2AMLogic/gf180-monosynth/docs/tr808-reference.md

# The Roland TR-808 voice circuits — an engineering reference for a digital 808

**Purpose.** This is the circuit-level reference for implementing an 808 in the
fixed-point drum model and the modal resonator bank of this chip
(`rtl-sketch/modal_dp.v`, `model/modal_fixed.py`). It answers, per voice, *what
generates the tone, at what frequency and Q, with what envelope, through what
filter*, and it ends each voice with a "what to implement" paragraph in DSP
terms. Breadth was traded for accuracy: every number is tagged.

**How claims are tagged.**

- **[verified: KEY]** — read directly in the cited primary source (the service
  notes' schematic or text, or a peer-reviewed analysis of it). Source keys are
  expanded in §0.
- **[inferred]** — computed by me from verified component values with the
  formulas given in §1, or read by me off the schematic scan where the wiring
  is unambiguous. Reproducible; not independently measured.
- **[could not establish]** — no primary source found; do not build on it.

Where a number below disagrees with folklore, the folklore is wrong or refers
to a different unit; see §13 and §15.

---

## 0. Sources actually consulted

| key | source | what it gives | reached |
|---|---|---|---|
| **SN** | Roland, *TR-808 Service Notes*, 1st ed., 15 June 1981 (3rd printing June 1983). Scan: <https://archive.org/details/synthmanual-roland-tr-808-service-notes> (PDF: <https://archive.org/download/synthmanual-roland-tr-808-service-notes/rolandtr-808servicenotes.pdf>) | p.5–6 "Sound Generators" circuit description of every voice; p.9 main-board voice schematic (BD, SD, toms/congas, RS/CL, CP/MA) with component values; p.13 voicing-board schematic (six oscillators, CB, CY, OH, CH); p.14 "typical and variable" tuning chart (frequency, decay time and output amplitude per voice); p.15 design changes | yes, full PDF, read as images |
| **W14a** | K. J. Werner, J. S. Abel, J. O. Smith, "A Physically-Informed, Circuit-Bendable, Digital Model of the Roland TR-808 Bass Drum Circuit", DAFx-14. <https://www.dafx.de/paper-archive/2014/dafx14_kurt_james_werner_a_physically_informed,_ci.pdf> | block-by-block BD analysis with transfer functions, the decay/attack/sigh mechanisms, comparison against SPICE and recordings | yes, full text |
| **W14b** | Werner, Abel, Smith, "The TR-808 Cymbal: a Physically-Informed, Circuit-Bendable, Digital Model", ICMC\|SMC 2014. Zenodo: <https://zenodo.org/record/850891> (DOI 10.5281/zenodo.850890; PDF <https://zenodo.org/api/records/850891/files/smc_2014_220.pdf/content>) | the six Schmitt oscillators and their nominal frequencies, the two band-pass filters, envelope generators, swing VCAs, high-pass filters, tone stage | yes, full text |
| **W14c** | Werner, Abel, Smith, "More Cowbell: a Physically-Informed, Circuit-Bendable, Digital Model of the TR-808 Cowbell", AES 137th Conv., 2014. Abstract: <https://pure.qub.ac.uk/en/publications/more-cowbell-a-physically-informed-circuit-bendable-digital-model>; paper: AES e-lib 17530 (paywalled) | cowbell band-pass analysis | abstract only |
| **W16** | K. J. Werner, *Virtual Analog Modeling of Audio Circuitry Using Wave Digital Filters*, Ph.D. dissertation, Stanford, 2016. <https://stacks.stanford.edu/file/druid:jy057cz8322/KurtJamesWernerDissertation-augmented.pdf> | Table 2.2 (bridged-T R/C values for BD, SD, toms, congas, RS, CL), Table 2.3/4.2 (BD feedback values), Appendix C (tom/conga diode branch) | yes, full text |
| **SOS-BD** | G. Reid, "Practical Bass Drum Synthesis", *Sound On Sound* Synth Secrets. <https://www.soundonsound.com/techniques/practical-bass-drum-synthesis> | qualitative BD description, 808 vs 909 | yes |
| **SOS-SD** | G. Reid, "Practical Snare Drum Synthesis". <https://www.soundonsound.com/techniques/practical-snare-drum-synthesis> | qualitative SD block diagram | yes |
| **SOS-CY** | G. Reid, "Practical Cymbal Synthesis". <https://www.soundonsound.com/techniques/practical-cymbal-synthesis> | six square oscillators, three bands | yes |
| **SOS-CB** | G. Reid, "Synthesizing Cowbells & Claves". <https://www.soundonsound.com/techniques/synthesizing-cowbells-claves> | cowbell/claves description | yes |
| **RW** | R. Whittle, "Modifications for the Roland TR-808". <http://www.firstpr.com.au/rwi/tr-808/> | practitioner statements: per-unit oscillator tuning, noise source, BD self-oscillation mod, snare/clap composition | yes |
| **MI** | Mutable Instruments `eurorack` sources: `peaks/drums/{bass_drum,snare_drum,high_hat}.cc`, `plaits/dsp/drums/{analog_bass_drum,analog_snare_drum,hi_hat}.h`. <https://github.com/pichenettes/eurorack> | a widely-copied open 808 model, for comparison | yes, source read |
| **WP** | Wikipedia, "Roland TR-808". <https://en.wikipedia.org/wiki/Roland_TR-808> | provenance only | yes |
| **MD** | M. Delp, "Anatomy of a Drum Machine". <http://mickeydelp.com/blog/anatomy-of-a-drum-machine> | qualitative only | yes |

Not reached in this pass (state this rather than guess): Eric Archer's 808 pages
(site returns 404/certificate errors), Werner's companion audio pages
(404), the AES cowbell paper body, the Nava/Yocto/x0x clone documentation, and
the Csound/Pd/SuperCollider/VCV implementations. No web search was available
for this pass; everything above was fetched by direct URL.

All frequencies/Q/τ marked [inferred] were computed with the formulas of §1
from the component values in SN and W16. τ is the amplitude 1/e time.

---

## 1. Things common to every voice

### 1.1 Trigger and accent

The CPU (µPD650C) produces a **common trigger** whose ON voltage is set by the
global ACCENT level, **4–14 V**, and per-instrument data that is ANDed with it
to give each voice a **1 ms pulse** of that amplitude **[verified: W14a §3;
SN p.5 Fig. 7 and p.14 "Common Trig with pulse width longer or shorter than
1 ms will be a cause of deteriorative voices"]**. Accent therefore scales the
*excitation* of every voice, not a VCA after it; and because several voices
have nonlinear VCAs downstream, accent changes timbre as well as level
**[verified: W14b §5]**. Roland's chart gives the resulting output swing per
voice at "normal" and "accent" (§1.6): ≈3× for the drums, only ≈2× for
CY/OH/CH, 1.7× for MA **[verified: SN p.14]**.

### 1.2 The bridged-T resonator (the tone generator of BD, SD, toms, congas, RS, CL)

Roland's own text: "The bridged T-network filter shown in Fig. 11 is used to
generate periodic damping drum sound. This configuration has variations
according to application… With this circuit, the decay time becomes longer as
Q increases" **[verified: SN p.5]**. Werner: "The 808 represented Roland's
first implementation of the bridged-T network, and it was used in every single
one of its sound generators in some form… The TR-808 snare drum, lo/mid/hi
tom/congas, and rim shot/clave all use bridged-T networks in similar ways to
the bass drum, to create decaying pseudo-sinusoids in response to impulsive
input. Bridged-T networks are also used as band pass filters in the remaining
voices: handclap, cowbell, cymbal, and open/closed hihat" **[verified: W14a
§5, fn. 15]**.

Topology **[verified: W14a §5–7; W16 Fig. 2.13, 2.27]**: an op-amp with the T
between its inverting input and output — two capacitor "arms" C1 (input side)
and C2 (output side) in series, bridged by R2, with the arms' junction ("foot",
Werner's V_comm) tied to ground through R1. The trigger pulse enters the
non-inverting input. In BD, toms/congas and RS/CL an extra inverting amplifier
feeds the output back into the foot through a resistor R_fb (BD: R170; toms:
R230/R259/R289; CL: R313) — Roland calls this "multi-feedback".

Transfer function from the pulse input (Werner's eq. 5, denominator):

    D(s) = s² R1 R2 C1 C2 + s R1 (C1 + C2) + 1
    f0 = 1 / (2π √(R1 R2 C1 C2))                        (Roland gives this formula, W14a fn. 16)
    Q  = √(R2/R1) · √(C1 C2) / (C1 + C2)   (= ½ √(R2/R1) for C1 = C2)
    τ  = Q / (π f0)                                       (amplitude 1/e)

R1 is the *total* resistance seen from the foot to ground (all shunt paths in
parallel) **[verified: W14a §5, "R_effective = R161 ‖ (R165+R166) ‖ R170"]**.

**With feedback** of (inverting) gain −g into the foot through R_fb, I derived
by nodal analysis the closed-loop denominator (it reproduces Werner's eq. 5
and eq. 7 as special cases) **[inferred]**:

    D_fb(s) = s² R1 R2 C1 C2 + s R1 [ (C1 + C2) − g · R2 C1 / R_fb ] + 1

so **feedback subtracts from the damping term and leaves f0 unchanged to first
order**; Q is multiplied by (C1+C2) / ((C1+C2) − g R2 C1/R_fb), and the network
self-oscillates when g R2 C1 / R_fb ≥ C1 + C2. This is exactly "decay raises
feedback toward self-oscillation". Checked against Roland's chart in §2.

Two real frequency effects exist on top of this, and neither is a "pitch
sweep oscillator": (a) BD only — for the first ≈4–6 ms the foot resistor is
shorted by a transistor, raising f0 by ≈2.6× (§2); (b) toms/congas — a diode
pair in the foot branch conducts at large amplitude, so the pitch starts high
and falls to the small-signal value as the ring decays (§4).

### 1.3 The "swing-type VCA"

Roland's name for a single-transistor common-emitter stage whose collector
supply *is* the envelope voltage, with a diode that shuts it fully off: "The
swing type VCA shown in Fig. 12 is used to generate metallic sound (noise).
This circuit features its output waveform having many high harmonic
components to provide ringing metallic sound" **[verified: SN p.5]**. Werner
analyses it as a modified common-emitter amplifier that clips "wildly" between
the envelope voltage and a lower edge that is itself a function of the
envelope, and fits it with a soft-clip of sharpness α = 3.5 **[verified: W14b
§8]**. It is used by RS (Q62), CB (Q14/Q15), CY (Q16–Q18), OH (Q27) and CH (Q30);
MA's gate (Q65) and the clap's tail VCA (Q70) are similar single-transistor
stages, while the clap's burst VCA is an OTA (IC22, BA662). Its practical
signature is asymmetric clipping whose amount tracks the envelope — i.e. the
hats and cymbal get *more* distorted, not just quieter, as they decay. MI's
Peaks approximates it as "amplifies only the positive section of the signal"
and Plaits as `s *= s > 0 ? 4 : 0.1; s = s/(1+|s|)` **[verified: MI]**.

### 1.4 The noise source

One generator on the main board: a reverse-biased transistor base–emitter
junction in avalanche (Q35, 2SC828-R, with trimmer TM4 setting the white-noise
level to 130 mV rms), buffered by IC24, distributed as a **W.N. (white)** bus
and a **P.N. (pink)** bus **[verified: SN p.8 schematic "NOISE GENERATOR",
p.14 adjustment table "NOISE GENERATOR TM-4 130 mV rms"; RW: "real noise from
a reverse-biased transistor junction going into avalanche breakdown"]**.
Whittle adds that there is "no significant difference in the audible quality
of the noise between one TR-808 and another" **[verified: RW]**. Wikipedia's
story that Kakehashi bought "faulty transistors" for the sizzle is provenance
only **[verified: WP]**.

SD (white, via its own VCA), CP (white, band-passed), MA (white, gated), and
LT/MT/HT (pink, low-passed) consume it. **CY, OH and CH do not use noise at
all** (§1.5).

### 1.5 The six Schmitt-trigger square-wave oscillators (CB, CY, OH, CH)

"The TR-808's Cowbell, Cymbal, Open Hihat, and Closed Hihat voice circuits all
work by filtering and enveloping rectangular waves. In fact, they all share a
common bank of six of these oscillators, ingeniously implemented with a single
HD14584 hex Schmitt trigger inverter chip" **[verified: W14b §3; SN p.6 "The
combined square wave outputs of six Schmitt triggers including two for CB
generator"; SN p.13 schematic, IC1 HD14584]**. Each is a one-resistor
one-capacitor astable; the chip is run from **5 V** (Q9/R60/R61 regulator),
giving amplitude 5 V and duty cycle 47.98 % **[verified: W14b §3]**.

Component values read from the p.13 schematic **[verified: SN]** and the
nominal frequencies Werner derives from them with the HD14584's typical
thresholds **[verified: W14b §3]**:

| osc | R | C | nominal f (W14b) | note |
|---|---|---|---|---|
| 1 (pins 5/6) | R40 560 kΩ | C1 0.018 µF | **205.3 Hz** | fixed |
| 2 (pins 3/4) | R41 560 kΩ | C2 0.01 µF | **369.6 Hz** | fixed |
| 3 (pins 1/2) | R42 680 kΩ | C3 0.01 µF | **304.4 Hz** | fixed |
| 4 (pins 9/8) | R43 220 kΩ | C4 0.018 µF | **522.7 Hz** | fixed |
| 5 (pins 11/10) | TM2 220 kΩ + R45 100 kΩ | C5 0.018 µF | 359.4–1149.9 Hz, **trimmed to 800 Hz** | "COWBELL FREQ.2 1.25 ms" |
| 6 (pins 13/12) | TM1 220 kΩ + R44 150 kΩ | C6 0.022 µF | 254.3–627.2 Hz, **trimmed to 540 Hz** | "COWBELL FREQ.1 1.85 ms" |

Werner's numbers correspond to f = 1/(k·RC) with k = 0.483, i.e. HD14584
thresholds of about V_T+ ≈ 2.7 V, V_T− ≈ 2.1 V at 5 V **[inferred; I
back-computed k from his 205.3 Hz and it reproduces all six of his figures to
0.1 Hz]**. The hysteresis of a 4584/40106 varies substantially between parts
(Roland's own design-change list blames "variations in HD14584 hysteresis" for
the tempo clock drifting out of range **[verified: SN p.15 item 1]**), so the
four untrimmed frequencies are nominal ±(tens of) percent, and "each machine's
six square wave oscillators [have] a unique set of frequencies" **[verified:
RW; W14b fn. 7]**. Only 540 and 800 Hz are factory-trimmed. Early units
(before serial 000300) used R44 = 390 kΩ and R45 = 330 kΩ **[verified: SN
p.15; W14b fn. 9]**.

The six outputs are summed passively through 120 kΩ each (R35, R37, R39, R46,
R48, R50) into R53 = 1 kΩ to ground **[verified: SN p.13; W14b eq. 4]** — a
sum of six 0/5 V squares, heavily attenuated, i.e. a 7-level staircase. This
sum feeds the two cymbal band-pass filters (§10) and, through separate gates,
the cowbell (§9).

### 1.6 Roland's tuning chart (the only manufacturer-published measurements)

Service notes p.14, "CHECKING VOICES … values are typical and variable",
measured at the voice outputs with level at maximum, accent at minimum then
maximum, all other knobs at 12 o'clock. Reproduced verbatim (period in ms,
frequency in Hz) **[verified: SN p.14]**:

| voice | normal Vpp | accent Vpp | f (low knob) | f (mid) | f (high knob) | decay short | decay mid | decay long |
|---|---|---|---|---|---|---|---|---|
| BD | 3.5 | 10 | — | 18 ms (56) | — | 50 ms | 300 ms | 800 ms |
| SD (H / L) | 3 | 10 | — | 2.1 ms (476) / 4.2 ms (238) | — | — | 60 ms | — |
| LC | 3.5 | 12 | 6.1 (165) | 5.4 (185) | 4.5 (220) | — | 180 ms | — |
| LT | 3.5 | 12 | 12.5 (80) | 11.1 (90) | 10 (100) | — | 200 ms | — |
| MC | 3 | 10 | 4 (250) | 3.6 (280) | 3.2 (310) | — | 100 ms | — |
| MT | 3 | 11 | 8.3 (120) | 7.4 (135) | 6.3 (160) | — | 130 ms | — |
| HC | 3.5 | 12 | 2.7 (370) | 2.5 (400) | 2.2 (455) | — | 80 ms | — |
| HT | 3.5 | 12 | 6.1 (165) | 5.4 (185) | 4.5 (220) | — | 100 ms | — |
| C (claves) | 2.5 | 8 | — | 0.4 (2500) | — | — | 25 ms | — |
| RS (H / L) | 3 | 10 | — | 0.6 (1667) / 2.2 (455) | — | — | 10 ms | — |
| M (maracas) | 3 | 5 | — | — | — | 25 ms | — | 35 ms |
| CP | 6 | 2 (sic) | — | — | — | — | 100 ms | — |
| CB (H / L) | 3.5 | 12 | — | 1.25 (800) / 1.85 (540) | — | — | 50 ms | — |
| CY | 3.5 | 7 | — | — | — | 350 ms | 800 ms | 1200 ms |
| OH | 3.5 | 7 | — | — | — | 90 ms | 450 ms | 600 ms |
| CH | 3 | 6 | — | — | — | — | 50 ms | — |

"Decay time" is not defined in the chart. Comparing it with τ computed from
the component values for the voices where the analysis is unambiguous (SD low
60 ms vs τ = 22 ms; LT 200 vs 92; LC 180 vs 91; CP tail 100 vs 47; BD mid 300
vs 144) gives a consistent ratio of **≈2.2–2.7 τ, i.e. the chart's "decay" is
about the time to −20 dB** **[inferred]**. Use τ ≈ chart/2.3 when only the
chart value is available.

### 1.7 Tolerances

"The voice circuits featured ±20 % capacitors and ±5 % resistors. These
variations have significant effects on the gain, center frequency, Q, decay
time, &c. of filter sections, especially when they are in feedback
configurations" **[verified: W14a §11]**. Every f0 below is therefore a ±10 %
nominal, and every high-Q figure a ±50 % nominal. Make all of them
programmable; do not hard-wire.

---

## 2. BD — bass drum

**Topology [verified: W14a §2–9; SN p.5–6; SN p.9 schematic].** Trigger
logic (Q39, Q40) → **pulse shaper** (C40 0.015 µF, R163 100 kΩ, R162 4.7 kΩ,
D53) → **bridged-T resonator** around IC12a (arms C41 = C42 = 0.015 µF,
bridge R167 = 1 MΩ, foot R166 6.8 kΩ + R165 47 kΩ to ground, with Q43 across
R165) with a **feedback buffer** IC12b (R164 47 kΩ in, R169 47 kΩ ‖ (VR6
500 kΩ "DECAY" + C43 33 µF) feedback) returning through R170 470 kΩ into the
foot; an **envelope generator** (Q41, Q42, C38 0.1 µF, R156 1 MΩ) that drives
Q43 and also produces a **retrigger pulse** through C39 0.033 µF / R161 1 MΩ /
D52 into the foot; then **tone** (R171 220 Ω + R172 10 kΩ ‖ VR5 10 kΩ, into
C45 0.1 µF — a passive 1-pole low-pass), **level** VR4, and an output buffer
Q44 with a DC-blocking high-pass (C49 0.47 µF, R176 100 kΩ, R177 82 kΩ).
Component values: W16 Tables 2.3 and 4.2 and the p.9 schematic agree.

**Pulse shaper [verified: W14a §4].** A passive low-shelf plus a diode. The
rising edge delivers the full trigger amplitude V_TRIG (4–14 V); the falling
edge, 1 ms later, is ≈ V_TRIG·R162/(R162+R163) + 0.71 V ≈ 0.045·V_TRIG + 0.7 V
and is clamped by D53 so the output never goes below ≈ −0.7 V. "It is the
edges of the shaped pulse that will kick the bridged-T network into
oscillation."

**Resonator [verified: W14a §5; computed with §1.2, inferred].**
R1 = R161 ‖ (R165+R166) ‖ R170 = 46.1 kΩ, R2 = 1 MΩ, C = 0.015 µF:
**f0 = 49.4 Hz, open-loop Q = 2.33 (τ = 15 ms)**. Werner reports "≈49.5 Hz,
which is close to the entry in Roland's 'typical and variable' tuning chart
(56 Hz)"; the service-notes text speaks of "16 ms … inherent oscillation
period" (62.5 Hz); Werner's SPICE/model plots of instantaneous frequency sit
between 48 and 58 Hz over the first 300 ms **[verified: W14a Fig. 11]**. Treat
**50–56 Hz** as the target and make it tunable.

**Decay control [verified: W14a §6; law inferred, §1.2].** The feedback
buffer's audio-band gain is g = (R169 ‖ k·VR6)/R164 for knob position k
(0 at k = 0; 0.914 at k = 1; C43 only blocks DC). Closed-loop Q from the §1.2
law with R_fb = R170:

| VR6 position k | g | Q | τ | 2.3 τ | Roland chart |
|---|---|---|---|---|---|
| 0 | 0 | 2.3 | 15 ms | 34 ms | — |
| 0.1 | 0.515 | 5.2 | 33 ms | 76 ms | "short" 50 ms |
| 0.5 | 0.842 | 22.3 | 144 ms | 330 ms | "mid" 300 ms |
| 0.9 | 0.905 | 63 | 408 ms | 0.94 s | "long" 800 ms |
| 1.0 | 0.914 | 84 | 544 ms | 1.25 s | |

Self-oscillation needs g = 0.94; the stock circuit tops out at 0.914, so the
stock BD **cannot quite sustain**, which is why Whittle's modification
"extends the Bass Drum decay range to include self-oscillation, so any decay
time from the normal minimum to infinity can be achieved" **[verified: RW]**.
The frequency is unchanged by the decay knob to first order. **Hypothesis 1
for the BD is confirmed.**

**Attack frequency shift [verified: W14a §8.1; SN p.6].** For the duration of
the envelope generator's pulse the collector of Q43 shorts R165, so the foot
resistance drops from 53.8 kΩ to 6.8 kΩ (R1 → 6.66 kΩ) and **f0 rises to
≈130 Hz with Q ≈ 6** for ≈4 ms (SN: "the ON period of Q43 is determined by
R156 and C38 and equals 4 ms which is ½ × ½ of 16 ms") — Werner measures ≈6 ms.
"Although this brief change of center frequency (≈6 ms, less than a single
period at the higher frequency) isn't long enough to be perceived as a pitch
shift, it greatly affects the sound of the bass drum's attack, making it
'punchier' and 'crisper'." When Q43 releases, C39/R161/D52 apply a
**retriggering pulse** so the amplitude does not collapse when the resonance
jumps back down **[verified: W14a §8.1; SN p.6]**.

**Pitch "sigh" [verified: W14a §8.2].** Separate from the attack shift: when
the foot node swings below ≈ −0.7 V, Q43's base–emitter conducts, drawing
current that lowers R_effective and raises f0 slightly; as the ring decays the
frequency relaxes back — a downward glide of a few percent over the first few
hundred ms ("goes slightly flat at long decays" **[verified: SOS-BD]**).
Werner fits it as a memoryless nonlinearity i_C = f(V_comm) (his eq. 8,
α = 14.315, V0 = 0.556, m = 1.4765·10⁻⁵).

**Tone [verified: W14a §9; values SN p.9; corner inferred].** One-pole RC
low-pass, R_eq = R171 + (R172 ‖ VR5·l), C45 = 0.1 µF: **corner from ≈7.2 kHz
(VR5 = 0, all click) down to ≈305 Hz (VR5 max)**. It acts on resonator *and*
click alike; the click *is* the shaped pulse leaking straight through (Plaits
models this as `exciter_leak = 0.08·(tone+0.25)` **[verified: MI]**).

**Retrigger while ringing [verified: W14a §11].** Because the resonator is a
filter with state, "each note is slightly different, as in a real 808, since
the remaining filter states may interfere constructively or destructively with
the response to a new trigger".

**What to implement (BD).** *Amended 2026-09-18 (DR 0009,
`drum-verification.md` §8.3): **f0 = 49.4 Hz**, not 56. The 56 Hz below was
Roland's chart's, and it contradicts this section's own derivation from the
component values four paragraphs above. It is also incompatible with the decay
table above: that table's Q and τ columns satisfy τ = Q/(π f0) to 1.5 % at
49.4 Hz and only to 12.8 % at 56, so the table is computed at 49.4. Two sample
sets measure 48.8–51.6 Hz.*

One two-pole resonator (a modal-bank mode) at
~~f0 = 56 Hz~~ **f0 = 49.4 Hz** (tunable 45–65 Hz), excited by a **1 ms rectangular pulse** of
amplitude ∝ accent. (The analog pulse shaper turns that pulse into a
positive kick of A at t = 0 and a negative kick of ≈0.05A + 0.7 V at t = 1 ms,
clamped at −0.7 V: a 1-pole high-pass with τ ≈ 0.1 ms and a one-sided clamp
reproduces it; feeding the raw 1 ms pulse into the bank is close enough to
start with.) Set the pole radius set from the decay knob by the table above
(Q = 2.3 → 84, τ = 15 → 540 ms; r = exp(−π f0/(Q f_s))). Optional but cheap
and audible: for the first 4 ms load the "attack" coefficients (f0 ≈ 130 Hz,
Q ≈ 6) and then switch to the normal ones while adding a second, smaller
negative kick (the retrigger). Optional: a pitch glide of −2…−5 % over 300 ms
that scales with amplitude (the sigh). Follow with a 1-pole low-pass whose
corner is the tone knob (305 Hz … 7.2 kHz) applied to resonator + a copy of the
excitation pulse (the click). Do **not** reset the resonator state on a new
trigger. The output high-pass is at 3.4 Hz — ignore it. Q2.24 coefficients at
48 kHz: see §14.

---

## 3. SD — snare drum

**Topology [verified: SN p.6 "This sound generator has two bridged
T-networks for fundamental waveforms and harmonic waveforms. The output ratio
of the two can be changed by VR8 (TONE) to tailor sound characteristic. The
amplitude of snappy envelope can be controlled by VR9 (SNAPPY)"; SN p.9
schematic; W16 Table 2.2; RW: "composed of the Snappy noise pulse and the
ringing of two 'Bridged T-Network' resonators, with the Tone pot controlling
the mix of the outputs of the two resonators"].**

Two bridged-T resonators around the two halves of IC14, with no feedback
buffer (the SD is not "multi-feedback"):

| | R1 (foot) | R2 (bridge) | C1, C2 | f0 [inferred] | Q [inferred] | τ | Roland chart |
|---|---|---|---|---|---|---|---|
| low, IC14a | R196 680 Ω | R197 820 kΩ | C58 = C59 = 0.027 µF | **250 Hz** | 17.4 | 22 ms | **238 Hz**, 60 ms |
| high, IC14b | R195 2.2 kΩ | R198 1 MΩ | C60 = C61 = 0.0068 µF | **499 Hz** | 10.7 | 6.8 ms | **476 Hz** |

So the June-1981 machine's snare is **≈240 Hz + ≈480 Hz, a 1 : 2 ratio**, with
the upper partial decaying 3× faster **[verified: SN chart; values SN/W16;
Q, τ inferred]**. The hypothesis "≈180 Hz and ≈330 Hz" is **refuted for the
1981 unit — but see the design change below, which lands exactly there.**

**Design change ("PORTION CHANGED" box on the p.9 schematic, 1983 printing)
[verified: SN p.9]:** "SD: C58 .027 to .056; C61 .0068 to .015; R191 8.2k to
10k; R200 47k to zero." No serial number or reason is given (the p.15
design-change table does not list it). With those values **[inferred]**:
low f0 = 1/(2π√(680·820k·0.056µ·0.027µ)) = **173 Hz** (Q 16, τ 30 ms);
high f0 = **336 Hz** (Q 10, τ 9.4 ms) — ratio 1.94. Later 808s therefore have
a snare a fourth lower than early ones. The tuning chart on p.14 was not
updated. Build both presets; default to the later one (it is the sound most
recordings and samples come from, but that is [inferred] from the chronology,
not measured).

**Excitation and the cascade [inferred from the schematic, SN p.9].** The
trigger (Q45/Q46) is shaped by R189 100 kΩ ‖ C57 0.0068 µF into R190 680 Ω and
enters IC14a's non-inverting input. IC14a's *output* is divided by R191
8.2 kΩ / R192 220 Ω (≈1/38) into IC14b's non-inverting input — the **high
resonator is driven by the low resonator's output, not by the pulse
directly**, so it is excited continuously by the fundamental and the two
partials are phase-locked. (Peaks and Plaits excite both with the pulse; the
difference is subtle.) IC13 sums IC14a (via C63 0.047 µF) and IC14b (via R200
47 kΩ → 0 Ω after the change, C65 0.047 µF) through VR8 TONE 100 kΩ(B), plus
the noise.

**Snappy / noise path [verified: SN p.6 text; wiring inferred from p.9].**
VR9 SNAPPY 10 kΩ(B) sets the amplitude of the trigger pulse fed to Q47, which
charges C51 0.47 µF through R186 33 kΩ (τ ≈ 15.5 ms) — the *noise envelope*.
That envelope controls Q48, a transistor VCA on the white-noise bus (W.N.
via C56 0.022 µF, R188 100 Ω). Q48's output goes through a Sallen-Key
high-pass on emitter follower Q49 (C66 = C67 = 0.0018 µF, R201 22 kΩ feedback,
R202 47 kΩ): **f0 ≈ 2.75 kHz, Q ≈ 0.7** **[inferred]**, then C69 0.01 µF /
R205 27 kΩ into the IC13 mixer. **"Snappy" is the noise level (via its
envelope amplitude); it does not change the resonators** — contrary to
SOS-SD's description, in which "the snappy signal is attenuated and added to
the trigger itself and directed to both oscillators"; the schematic shows VR9
only in the Q47 noise-envelope path **[inferred from SN p.9]**. The noise
envelope's decay is fixed (≈15 ms RC, so the "snap" is a 30–40 ms burst);
the tone resonators' decays are fixed by their component values.

**What to implement (SD).** Two modal-bank modes: low at 173 Hz (Q 16) and
high at 336 Hz (Q 10) [later units], or 238/476 Hz (Q 17/11) [early units].
Excite the low mode with the 1 ms pulse; excite the high mode from the low
mode's output ×1/38 (or, if the bank cannot chain, from the same pulse — the
loss is small). TONE = crossfade of the two mode amplitudes (Roland: "output
ratio of the two"). Noise: white LFSR × exponential envelope → 2-pole filter
at 2.75 kHz Q 0.7 → add. Total: 2 resonator modes + 1 noise biquad + 1
envelope.

> **AMENDED 2026-09-18 from hardware** (`docs/drum-verification.md` §8.1,
> §8.6; contract 17.22, 17.24, 17.25). Three numbers in this section are
> right and three readings of them are not:
>
> - the noise filter is a **band-pass** on the stated pole, not a high-pass.
>   The pole (2.75 kHz, Q 0.7) is kept exactly; only the numerator changes. A
>   high-pass on that pole is flat to Nyquist, and the machine's snare noise
>   peaks at 3–5 kHz and falls above (band-pass 1.9 dB weighted rms against
>   the high-pass's 5.2);
> - the noise envelope's decay is **τ ≈ 30 ms**, not the 15.5 ms of
>   R186 × C51 — which is the *charge* path. The machine's burst measures T20
>   63–78 ms over six files, and this section's own prose ("the snap is a
>   30–40 ms burst") agrees with the measurement rather than with the RC;
> - TONE's crossfade has a **measured value at 12 o'clock**: the upper partial
>   sits at **1.42×** the lower, the same with the snappy path up and down.
>   What is *not* solved is that ratio from R191/R192/VR8/R200; it is measured,
>   not derived.

---

## 4. LT / MT / HT and LC / MC / HC — toms and congas (three shared circuits)

**Topology [verified: SN p.6: "These three sound generators are composed of
the circuits based on the same principle… composed of a multi-feedback,
bridged T-network including IC5 as an active element. Voices are switched by
SW8 (C77 — frequency, R224 — level). While the oscillation is large in
amplitude immediately after triggering, it is on a higher frequency due to
conductions of D80 and D81, which reduce time constant of the filter. As the
resonance is damped, its frequency is lowered by the effect of increasing
diodes' internal resistance… Pink noise with a slightly longer decay time is
mixed for Low Tom Tom to provide artificial reverberation"; SN p.9 schematic;
W16 Table 2.2, Appendix C].** The tom and the conga of each pair are **the same
resonator with a capacitor switched in (tom) or out (conga)** and, for toms
only, a pink-noise path switched in. The panel switch selects one or the other;
they cannot sound together.

Values (SN p.9 / W16 Table 2.2) **[verified]**; frequencies **[inferred]** with
R1 = (1−x)·VR + R_side = 1.0–1.5 kΩ (VR11/13/15 = 500 Ω TUNING, R231/260/287 =
1 kΩ, diodes 1S188FM germanium *non-conducting* at small signal), R2 = 820 kΩ
(R228/R257/R284), feedback g = 1 through 820 kΩ (R230/R259/R289; IC15b/17b/18b
are unity-gain inverters, 33 kΩ/33 kΩ):

| voice | C1 (input arm) | C2 (output arm) | f0 at tuning min/mid/max | Roland chart | Q (with fb) | τ | chart decay |
|---|---|---|---|---|---|---|---|
| LT | C76 0.056 µF | C78 0.012 + C77 0.047 = 0.059 µF | 79 / 86 / 97 Hz | 80 / 90 / 100 | 25 | 92 ms | 200 ms |
| LC | C76 0.056 | C78 0.012 | 175 / 192 / 214 | 165 / 185 / 220 | 55 | 92 ms | 180 ms |
| MT | C89+C90 0.0352 | C91+C92 0.039 | 123 / 134 / 150 | 120 / 135 / 160 | 24 | 58 ms | 130 ms |
| MC | C90 0.027 | C92 0.012 | 252 / 276 / 309 | 250 / 280 / 310 | 38 | 44 ms | 100 ms |
| HT | C103 0.027 | C104+C105 0.0276 | 166 / 182 / 204 | 165 / 185 / 220 | 25 | 44 ms | 100 ms |
| HC | C103 0.027 | C105 0.0056 | 369 / 404 / 452 | 370 / 400 / 455 | 56 | 44 ms | 80 ms |

The agreement with Roland's chart is within 5 % across all six once the diodes
are treated as open **[inferred]**. (W16 Table 2.2 lists R1 = 333–500 Ω, which
is the diode-*conducting* limit; with those values every frequency comes out
1.7× too high against the chart — that is the large-signal pitch, see next.)

**Pitch drop [verified: SN text; magnitude inferred].** With the diodes fully
conducting the foot resistance becomes (1−x)·500 + 1 kΩ ‖ x·500 → 333–500 Ω,
i.e. f0 up to ≈1.7× the small-signal value (LT ≈ 145 Hz at the very start of
a hard hit, settling to 86 Hz). The transition is amplitude-dependent and
gradual (germanium diode, soft knee), not a stepped envelope. The congas share
the mechanism. This, not any envelope, is the toms' characteristic "doom"
sweep; it also means **accent changes the pitch envelope**.

**Noise (toms only) [verified: SN text; values inferred from p.9].** The
P.N. bus is gated by Q52/Q55/Q58 with an envelope from a diode-charged RC
(D55, C72 0.039 µF, R218 2.2 MΩ / R216 15 kΩ — ≈85 ms decay), low-passed by
R222 22 kΩ / C75 0.018 µF (**≈400 Hz, 1-pole**) and mixed in only in the tom
position of the switch. SN mentions it for LT ("slightly longer decay time
… artificial reverberation"); the schematic has the same path on all three.
It is a quiet, dark rumble under the tone.

**What to implement (toms/congas).** One modal-bank mode per voice at the
chart frequency (LT 90, MT 135, HT 185 / LC 185, MC 280, HC 400 Hz; the TUNING
pot spans ±10 %), Q ≈ 25 (toms) / ≈ 40–55 (congas), excited by the 1 ms pulse
× accent. Add the **amplitude-dependent pitch offset**: f = f0·(1 + 0.7·
sat(|y|/y_knee)) or, cheaper, a decaying pitch offset of +40 % → 0 over
≈ 2τ scaled by accent — the bank must accept per-sample coefficient updates or
a short coefficient ramp (a 4–8 step ramp of a1 is enough; a2 changes little).
Toms only: pink noise (LFSR + 1-pole low-pass at ≈400 Hz) × envelope
(τ ≈ 85 ms) at low level. Congas: no noise.

---

## 5. RS — rimshot, and 6. CL — claves (one shared circuit, switch SW11)

**Topology [verified: SN p.6 "RS/CL"; SN p.9 schematic; W16 Table 2.2].**
Two bridged-T networks:

- **IC21 network** (R315 5.6 kΩ, R316 1 MΩ, C115 = C116 = 0.0047 µF):
  **f0 = 453 Hz, Q = 6.7, τ = 4.7 ms** **[inferred]** — Roland chart RS "L"
  = 455 Hz **[verified]**. Used by RS; in the CL position its output "routed
  via R320 can be ignored because of its minimized level" **[verified: SN]**.
- **IC20a network** (R312 1 kΩ, R308 820 kΩ, C117 = C119 = 0.0022 µF):
  **f0 = 2526 Hz, Q0 = 14** **[inferred]** — Roland chart C = 2500 Hz
  **[verified]**. In the **CL** position IC20b (unity inverter, R314/R309
  33 kΩ) feeds back through **R313 390 kΩ** into the foot ("wired for high Q"
  **[verified: SN]**); by the §1.2 law g·R2·C1/R_fb = 0.00463 µF exceeds
  C1+C2 = 0.0044 µF, i.e. the linear model puts the claves **at or past the
  self-oscillation boundary** (Q → ∞; at g = 0.9 Q ≈ 270) **[inferred;
  component tolerance decides on which side a given unit sits]**. The output
  is hard-gated (below), so this is harmless — and it is why the claves ring
  so purely.
- In the **RS** position R313 is disconnected ("makes IC20b just a buffer"
  **[verified: SN]**) and the switch connects **C118 0.0022 µF** across the
  output arm, in parallel with C117 → C2 = 0.0044 µF: **f0 = 1786 Hz, Q = 13.5,
  τ = 2.4 ms** **[inferred from the switch wiring on p.9]** — Roland chart RS
  "H" = 1667 Hz **[verified]** (7 % apart, within tolerance).

**Gating and envelope [verified: SN text; values inferred].** Both voices'
outputs pass IC19 only while JFET Q74 (2SK30A) is released by the trigger
pulse through Q61 (C112 0.022 µF, R305 1 MΩ: **≈22 ms window**); "this
switching is provided to eliminate noise leaking from IC20, especially for CL"
**[verified: SN]**. For RS additionally, IC20b's output (via R318 220 kΩ) and
IC21's (via R320 22 kΩ) are summed into the **swing VCA Q62** whose envelope is
R107 1 kΩ / C24 0.47 µF (**τ ≈ 0.5 ms** — essentially the trigger edge) —
"VCA of this type is intended to provide many high harmonics in the output
signals" **[verified: SN]**. Chart decays: CL 25 ms, RS 10 ms **[verified]**.

**What to implement (CL).** One modal-bank mode at 2500 Hz with very high Q
(≥ 100; or literally a sine oscillator) excited by the pulse, multiplied by
a **gate envelope of ≈22 ms** (rectangular with a ≈2 ms fall is enough; Roland
chart 25 ms). Level ≈ 0.7 of the drums (2.5 vs 3.5 Vpp).

**What to implement (RS).** Two modes: 455 Hz (Q 6.7) and 1700–1800 Hz
(Q 13), both excited by the pulse; sum → **swing-VCA nonlinearity** (asymmetric
soft clip, positive gain ≈ 4×, negative ≈ 0.1×) with an envelope of τ ≈ 1 ms
→ gate of ≈22 ms → optionally a 2-pole high-pass to remove the thump. The
distortion is the sound; do not skip it.

---
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
