2AMLogic/gf180-monosynth/docs/milestones.md

# Milestones

Six, in order. Each names its **evidence**, its **blockers**, and what it does
**not** claim. No aggregate "quality" number — progress is cells and milestones
moving, not a score going up.

**Coverage is reported alongside results, always.** *"20 passing, 4 failing,
6 without verdicts"* is honest; *"83 % passing"* conceals the missing
verification. A milestone needs **both** sufficient valid coverage **and**
passing critical requirements, or the cheapest route to green is to make rows
unmeasurable.

---

## 1. Reference rig qualified · **IN PROGRESS**

Every comparison downstream is worthless until the rig is known to produce what
it claims. We have already had three instances of it not doing so.
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
