2AMLogic/gf180-monosynth/docs/img/drum-verification/CP.png

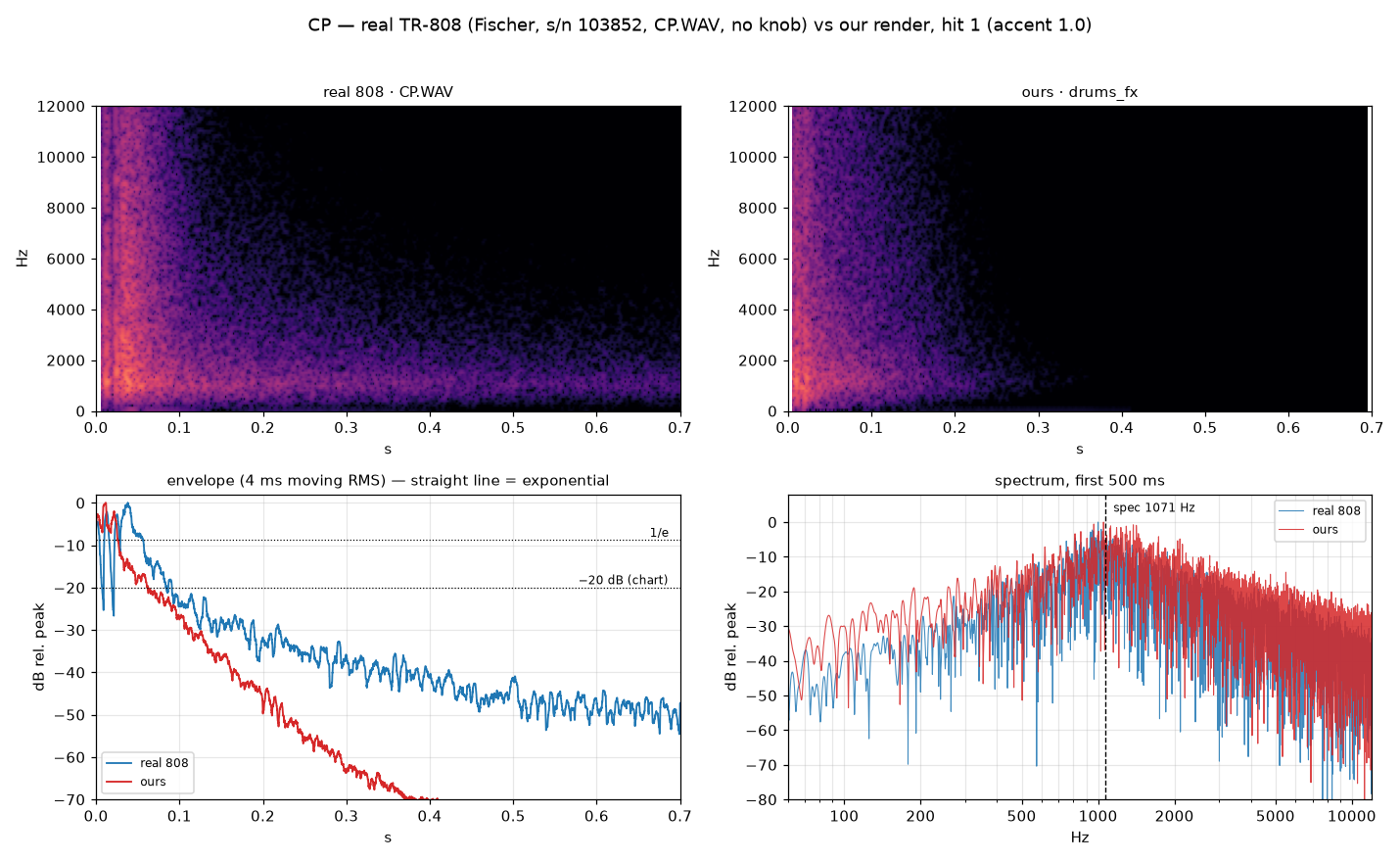
docs/img/drum-verification/CP.png
