2AMLogic/gf180-monosynth/docs/img/drum-verification/knob-laws.png

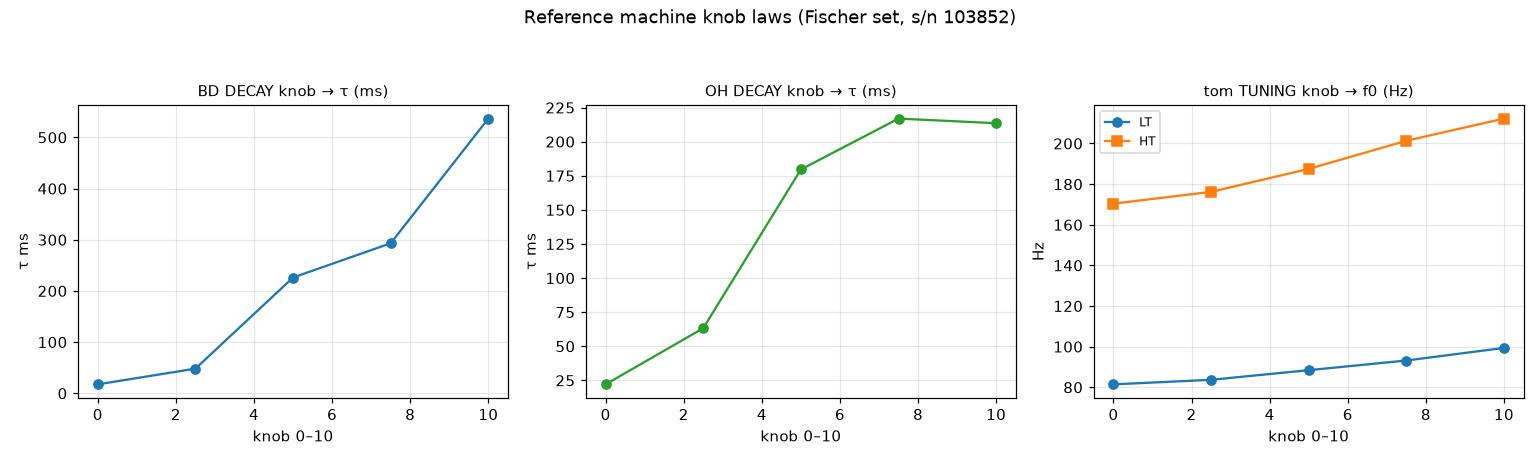
docs/img/drum-verification/knob-laws.png
