2AMLogic/gf180-monosynth/(commit log)

2026-09-17 Initial: audition harness, fixed-point ladder model, area sketch
    A Minimoog-shaped monosynth voice for gf180mcu -- three detuned oscillators
    into a nonlinear four-pole ladder -- plus drum voices. Sibling to
    gf180-polysynth, which has four voices and no filter at all.
    What is here, and what is deliberately not:
    audition/ float models of three candidate architectures (ladder monosynth,
    drum machine, FM), and play.py, a real-time playable instrument.
    This is how the architecture was chosen: by ear, before any RTL.
    model/ the fixed-point filter, its sizing sweep, and 8 regression tests
    rtl-sketch/ a time-shared ladder datapath for AREA ESTIMATION ONLY -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
    [ladder_dp.v]
2026-09-17 docs(dr): 0001 -- Huovilainen's ladder, and why not the more accurate models
    Decides the filter model before RTL exists, since it determines the datapath,
    the clock budget and most of the area.
    Huovilainen over ZDF/Newton-Raphson and over Levien's matrix form, and the
    reason is the SOLVER, not accuracy. Silicon has a fixed clock budget per
    sample -- 256 clocks at 12.288 MHz over 48 kHz -- and the sequenced ladder
    spends 10-20 of them deterministically. Newton-Raphson for this filter
    'converges slower and slower as you raise the feedback and the cutoff', so its
    worst case is exactly high resonance with the filter open, which is how the
    instrument gets played. A fixed-latency pipeline would h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
2026-09-17 PolyBLEP oscillators, delay-line instruments, and a measured clock budget
    Three things, all measured.
    BAND-LIMITED OSCILLATORS. The naive ramp was the biggest defect in the
    instrument -- -14.8 dB of inharmonic energy at note 88, worse and more
    objectionable than any difference between filter models. PolyBLEP removes
    about 16 dB of it uniformly on both saw and square, for a compare and ~3
    multiplies applied only within one phase increment of the discontinuity. No
    iteration, fixed latency. It needs 1/dt, which is constant for a held note, so
    it is computed at note-on rather than divided per sample.
    The square's correction had its sign inverted on first attempt and measured
    5 dB WORSE than na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
    [tb_cycles.v]
2026-09-17 Modal resonator sketch: "something you can hit", with no RAM at all
    Measured, alongside the ladder:
    block cycles cells RAM
    ladder filter 20 1,917 0
    modal resonator, 4 modes 18 4,683 0
    --
    both 38 of 256 clocks
    Modal synthesis rings by recursion, not by delay: each mode is a two-pole
    resonator y[n] = x[n] + a1*y[n-1] + a2*y[n-2], excited by a short noise burst.
    There is no delay line, so the entire state is two registers per mode -- eight
    registers for a four-mode bar, against the 1.2 KB per voice Karplus-Strong
    needs at low E. That is what makes it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
    [modal_dp.v, tb_modal.v]
2026-09-17 Capacitive touch sketch: an interface with no analog design
    568 cells, 316 flops, 8 pads, zero analog blocks and zero RAM.
    Drive the pad high, release to high-Z, count clocks until the input buffer
    reads low as it bleeds off. A finger adds roughly 5-20 pF to a ~10 pF pad, so
    the count rises measurably. One bidirectional pad and a counter per pad -- the
    CapSense trick -- which makes "an instrument you hit" reachable without an ADC,
    a comparator, or any mixed-signal qualification.
    Velocity is free: the rate of change of the count between scans is how fast the
    finger is approaching, so a hard hit and a slow press differ with no extra
    hardware.
    This matters because the fleet's analog route is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
2026-09-17 docs(dr): 0002 -- the product this block is for
    Fixes the product constraints, because several are already load-bearing on the
    RTL: a battery decides whether there is power management, the host decides the
    control interface, and a keychain decides pin count and die area.
    The target is a USB-C bus-powered, class-compliant MIDI sound module, keychain
    sized. Plug into a laptop, phone or tablet; no driver; play from any MIDI
    source.
    The market gap is specific, and it is not "no good small synths" -- there are
    many and they are excellent. It is two things. The ladder filter is still
    priced as a premium analog feature: the cheapest new Moog with one in 2026 is
    the Messenger at EUR611, which the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
2026-09-18 docs(dr): withdraw DR 0002's commercial argument, keep its engineering constraints
    Eight corrections, recorded alongside the original rather than rewritten.
    The load-bearing error: the 'EUR611 ladder filter floor' is false. The Moog
    Mavis is $349 ($299 promo) with a genuine Moog ladder filter, and the
    Werkstatt-01 was cheaper still. The source said 'cheapest route into a
    brand-new Moog KEYBOARD'; I dropped the word keyboard and substituted a much
    broader claim. Quoting accurately and then generalising past the quote is the
    specific failure, and the price gap it implied was what the argument rested on.
    Also corrected: a digital model of a ladder is not 'the same voice' (bit-exact
    agreement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
2026-09-18 docs: consolidate the design state, including what is not done
    One document for what has been decided and measured, because the reasoning was
    scattered across issue comments in two repos and was unusable to anyone who was
    not present for it.
    Includes the gap list, which is the part most worth reading: no RTL has been
    verified for correctness (the sketches are area and cycle estimates only), the
    reference model is not yet fully integer, there is no numeric contract for this
    instrument, no PDK has been run so there is no area/timing/power in real units,
    and there is no hardware.
    Also records the foundational process finding: gf180mcu's digital libraries are
    built from 0.5-0.6 um 5V transisto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
2026-09-18 model: fully integer voice (oscillators, fixed-point PolyBLEP, ADSRs, cutoff ROM) (#2)
    * model: fully integer voice -- oscillators, PolyBLEP, mixer, ADSRs, cutoff ROM
    Closes the gap fixed_render.py described: the ladder was integer, the
    oscillators and envelopes were float quantised at the filter input. Now
    every per-sample operation is integer; float remains only where note-on
    register values and ROM contents are computed from physical units.
    PolyBLEP: increment normalised at note-on to a 16-bit mantissa, 16-bit
    reciprocal, one 16x16 multiply per sample. Measured: aliasing suppression
    identical to float at every note (-42.7 / -36.6 / -31.0 dB at notes
    40/64/88); reciprocal width does not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
2026-09-18 Ladder and modal RTL verified bit-exact against the models; the old cell counts withdrawn (#3)
    * model: expose LadderFx.coefficients(); derive the tanh ROM images from the model
    The four integers process() actually runs on -- g per sample, k, gain and
    ogain -- are now computed by one method, so a testbench can hand the RTL
    exactly what the model used. Pure refactor: process() output is unchanged
    (SHA-256 of a two-patch render identical before and after) and the eight
    regression tests pass.
    While there, the docstring's "Q0.16" for gain/ogain was wrong and the RTL
    had been sized from it: gain = 2.6*drive is 19 bits at drive 3, ogain is 17
    bits, and k = 4*res needs 17 bits from res = 1.0. Rec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
    [ladder_dp.v, modal_dp.v, tanh_rom.py, tb_cycles.v, tb_ladder.v, tb_modal.v, tb_modal_fx.v]
2026-09-18 docs: five corrections to DESIGN.md from review
    - GF180 is a 180 nm process; it is the DIGITAL STANDARD-CELL LIBRARIES that use
    5V devices with 0.5-0.6 um gate lengths. The earlier framing overstated it.
    The rule is narrower: take timing from the library, not the process name.
    - The 18x18 MAC timings come from a Python STA with no clock-tree skew and no
    detailed routing. That supports the clock choice and is not timing closure;
    it now says so where the numbers appear.
    - 218 free cycles over a 20-25 cycle voice is 8-10 voices, not 8-14. The old
    upper bound used the bare 5-formant cascade rather than a complete voice.
    - 'No filter with a 20 kHz passband removes a 29 kHz image' was to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
2026-09-18 spec: numeric contract for the voice, revision 1 (proposed, not ratified) (#4)
    spec/NUMERIC-CONTRACT.md writes the integer voice down completely enough
    that two implementations would produce bit-identical output, derived from
    model/voice_fx.py and model/fixed.py as committed. The model wins where
    prose and code could be read differently, and the document says so.
    Specified: the frame and the 256-cycle clock, with "immediately before
    frame f" defined by the acceptance cycle of a write's last unit; the control
    register image and the semantics of each write (physical layer left open);
    24-bit phase accumulators, NOTE_INC, the five waveforms, the midpoint-sampled
    sine, and the fixed-point PolyBL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
2026-09-18 model+spec: clamp every host conversion to its register width; define inc = 0 (contract rev 2) (#5)
    Three defects the numeric contract recorded as open items 17.7 and 17.9,
    plus the rest of their class, found by sweeping every conversion of 5.5
    against the register widths of 5.1 and every legal register value back
    through the model.
    a_inc = 2^24 for attacks shorter than two frames (attack_s < 41.67 us,
    including 0). Clamped to 2^24 - 1: unobservable, either
    value completes the attack in one update from any level,
    so the register stays 24 bits.
    rate = 65536 for releases <= 4/(17 ln2 * 48000) = 7.072 us; and
    release_s = 0 d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
2026-09-18 spec: DR 0003-0006 -- note-on, glide, gain structure, resonance compensation; contract revision 2 (proposed) (#7)
    Four decision records, each proposed and not ratified, resolving open items
    17.1, 17.2, 17.5 and 17.6 of the numeric contract from what real instruments
    do, with sources cited and the gaps stated, and each implemented in the
    model with tests:
    0003 Note-on: GATE_ON and a new TRIG re-enter ATTACK from the current
    level (the Model D's contour and every modern Moog's default);
    nothing resets a phase or the ladder; priority, single/multi
    trigger and paraphonic allocation are the host's, with a reference
    host (last-note, single-trigger) informative.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
    [ladder_dp.v, tb_ladder.v]
2026-09-18 docs: measured area budget — what fits in a 1.73 mm² quarter slot (#6)
    * docs: measured area budget -- what fits in a 1.73 mm2 quarter slot
    Every figure yosys+ABC against gf180mcuD, gf180mcu_fd_sc_mcu7t5v0, tt_025C_5v00,
    cell area unless stated. Core area assumes 50% utilisation, which the routed
    ladder_dp confirms (51.6%, cell->die 2.00x).
    THE MODAL BANK IS NOT INFLATED BY ITS PARALLEL PORTS. That hypothesis is
    refuted: the mux trees on the twelve coefficient ports are ~5% of the block.
    It is big because Q2.24 coefficients against 28-bit state need a 28x26
    multiplier, which is 94,113 um2 -- 62.5% of the whole block. The Q2.24 sizing
    is itself necessary: the sweep found Q2.16 sits 2.4%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
2026-09-18 docs: TR-808 voice-circuit reference for the digital 808 (#8)
    Circuit-level reference for every TR-808 voice, written for the engineer
    building the fixed-point drum model: generator topology, frequencies, Q,
    decay constants, envelopes, post-filters and front-panel semantics, each
    ending in a "what to implement" paragraph in DSP terms, plus a mapping of
    the bridged-T voices onto the modal resonator bank as Q2.24 presets.
    Every claim is tagged verified (with URL), inferred, or could-not-establish.
    Primary sources: the June-1981 service notes (schematics read as images,
    Roland's own circuit description and tuning chart), Werner/Abel/Smith's
    DAFx-14 bass-drum and ICMC-2014 cymbal analyses, and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
2026-09-18 docs: verification rules -- start red, carry controls, area is not correctness (#10)
    Three rules, each learned the expensive way today.
    START RED is the new one and the reason for this file. This repo was already
    model-first -- a Python reference model as the spec, RTL compared against it --
    and still shipped four harnesses that had never been observed to fail: the
    cocotb suite that died at import while reporting four bugs 'caught' in 1.6 s;
    ladder_dp_t16.v whose every output was X behind a 1,917-cell area figure quoted
    three times; tb_ladder_n.v reading 120-bit words from a 128-bit vector file, so
    incapable of passing against anything; and voice_dp.v, bit-exact over 43,200
    frames with zero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
    [cells_adders.v, cells_latch.v, ladder_dp_stub.v]
2026-09-18 top level: SPI control interface, ARCHITECTURE.md, synth_top.v; touch cut (#9)
    * top level: SPI control, ARCHITECTURE.md, synth_top.v; capacitive touch cut
    DR 0007 decides the control interface: SPI for the wires, register writes for
    the meaning, the frame tick for the time. One 32-bit transaction is one
    register write, applied at the next frame tick. The stop/slice model from
    gf180-polysynth#7 contributes its transport and its CS framing and nothing
    else -- a state-based stop model discards MIDI's sub-millisecond timing by
    construction, and the client here is an MCU translating USB-MIDI, not a
    sequencer that knows the slice grid.
    Four pins (SCK, MOSI, CS_N, MISO). Mode 0, 32 bits per tran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
2026-09-18 voice: the bench can fail -- eight negative controls, an all-X stub, every tap compared, 255,060 frames of coverage (#12)
    voice_dp.v was bit-exact against model/voice_fx.py over 43,200 frames of three
    scenarios with zero injected-bug controls, so nothing had shown the bench could
    detect a defect. This makes it meet the standard the ladder and modal benches
    set (docs/verification-rules.md), without changing the datapath.
    Negative controls, INJECT_BUG_VOICE_*, each run on the scenario that reaches
    it (quick set; sample / tap mismatches):
    SQUARE_SIGN the square takes the saw's sign at the wrap 372 / 1,428 of 1,200
    ENV_FLOOR release without max(1, .) 4,791 / 20,83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
    [recip_div.v, tb_voice.v, test_rtl.py, verify_voice.py, voice_dp.v, voice_dp_stub.v]
2026-09-18 docs: CLAUDE.md -- how to wait cheaply, and worktree hygiene (#13)
    Five of six agents on this repo burned a large fraction of their budget in
    polling loops after their work was already complete on disk. The cost is not
    the check, it is the turn: waking to look at a job re-processes the whole
    context, so 'ls build/' costs what a hard reasoning turn costs, and twenty
    polls is twenty full-context passes containing no work.
    Records the three cheaper primitives -- block in one command with
    run_in_background so the wait costs zero turns, chain the follow-up work into
    the same command rather than returning to the model between steps, and end the
    turn since a completion notification re-invokes you.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
2026-09-18 drums: measured against a real TR-808 -- the snare is missing half of itself, all four suspected defects refuted (#15)
    Reference: the Michael Fischer / Technopolis set, CC0-1.0 via TidalCycles,
    sampled from a real TR-808 serial 103852 at the individual voice outputs,
    with every knob position in the filename -- so BD5050 is the exact
    "all knobs at 12 o'clock" condition Roland's June-1981 chart was measured
    under, which is where every preset in kit_808() comes from. Not committed
    (12 MB of audio, and *.wav is ignored); model/drum_verify.py takes its path.
    All four suspected defects are refuted, three of them measurement artefacts:
    BD decays in 127.4 ms not 3.4 (the 1/e first-crossing read a t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
2026-09-18 model: an acceptance suite for the Minimoog voice -- one test per claimed musical property, and six injected defects that turn it red (#16)
    Every existing test in model/ asks whether the integer model matches the float
    model, or whether the RTL matches the integer model. None asked whether the
    thing being built is the thing the decision records describe. This adds that
    suite: 42 tests, one per claimed musical property, each citing its DR or
    contract section and its tolerance.
    the filter res = 1 is the self-oscillation onset at 30 Hz .. 21.6 kHz
    within 0.39 % (DR 0006, bisected on the fixed-point filter);
    the pitch it sings at, locked to DR 0006's table so t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
2026-09-18 docs: correct two arithmetic errors the acceptance suite caught (#17)
    Both are mine, both are summary prose, neither changes the model.
    DR 0006 said the residual self-oscillation tuning error is 'within 14 cents'
    below 2 kHz. It is not: 0.968x the cutoff is -56.3 cents, and the clamp is
    -171. Fourteen cents is a ratio of 1.0081, i.e. 0.81%, while this error is
    3.2%. Corrected to 57 cents with the arithmetic shown.
    DR 0001 and DESIGN.md said self-oscillation tracks cutoff within +-2% 'from
    200 Hz to 1.6 kHz'. DR 0006's own table gives 0.979 at 200 Hz, which is 2.06%
    -- just outside its own bound. The claim holds from 400 Hz up; corrected, with
    the 200 Hz figure stated rather than dropped.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
2026-09-18 test: an executable "is this really an 808?", on the shared measurement library (#18)
    Adds `model/test_808_acceptance.py`, extends `model/audio_measure.py` with what
    the drum work needed, and gives both acceptance suites a CI step. Nothing main
    already had is removed: the library diff is +146/-34 and the 34 are lines
    deliberately replaced inside four functions.
    The acceptance suite holds `model/drums_fx.py` to `docs/tr808-reference.md`
    section by section, and where `docs/drum-verification.md` has since measured a
    real TR-808, to that: the bass drum's fundamental, its decay across the whole
    DECAY control and the fact that the control does not move the pitch; the
    snare's two resonators, SNAPP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
2026-09-18 Drum section: merged with main, and the three faults a real TR-808 found — contract rev 6 (DR 0009, DR 0010) (#14)
    * model+rtl+spec: the drum section as a TR-808 on the modal bank (DR 0007, contract revision 4)
    The drum section is real: an integer reference model (model/drums_fx.py)
    that is the specification, RTL bit-exact against it, negative controls
    watched to fail, and audio.
    Built from docs/tr808-reference.md rather than the strawman: BD, SD and
    the toms are bridged-T resonators, i.e. coefficient presets of the modal
    bank; CH, OH and CB are six square oscillators through a band-pass mode,
    the swing VCA (x4 / /8 into the ladder's tanh table) and a high-pass mode;
    SD's snap and CP are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
    [drum_dp.v, drum_kit.v, gen_modal_rom.py]
2026-09-18 FPGA: synth_top routed on ECP5 — and the three area numbers this repo had been arguing about (#31)
    SD's snap and CP are one white-noise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
    [fpga_top.v, mode_cfg_regs.v]
2026-09-18 Integration: the control link could not carry the drum image; the real drum engine connected and the chip verified at its pins (#30)
    * ctl: the control link could not carry the drum image -- 48-bit frame (DR 0007 rev 2)
    Measured, not argued: of the 155 register writes model/voice_fx.py and
    model/drums_fx.py perform for one patch and the reference kit, DR 0007
    revision 1's 32-bit frame {F, A[6:0], D[23:0]} corrupts 118. 118 drum writes
    have no page to go to at all; 67 addresses do not fit in 7 bits (contract
    15.1's A_PATH = 0x80, A_MODE = 0xC0, A_RESET = 0xFF); 26 values do not fit in
    24 (ENV_CTL is 27 bits, MODE_A1/A2 are 26). Both sides were separately
    bit-exact against their models, which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
    [drum_regs.v, i2s_tx.v, ladder_dp_n.v, spi_ctl.v, spi_ctl_dr7rev1.v, synth_top.v, tb_ctl.v]
2026-09-18 P&R: synth_top routed on gf180mcu -- the chip with placeholder drums fits the quarter slot at 56.7 %, the chip with the real drums does not fit at all (#34)
    `synth_top` had never been placed and routed; every area number for the
    complete design was arithmetic on separately-measured cell areas. Two runs
    through ORFS on gf180mcu (7t, tt_025C_5v00, 81.38 ns), both on a FIXED die so
    that the utilisation is the measurement and not a restatement of the input:
    * `2a88c35` -- synth_top with `drum_section_placeholder`, the design
    ARCHITECTURE.md section 10 describes. Routes inside the 1.7319 mm^2
    wafer.space quarter slot: 28 810 -> 30 542 instances, final standard-cell
    area 948 985 um^2 = **56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
2026-09-18 FPGA: the real joined instrument routed on an ECP5, and the clock the board actually makes (#39)
    * FPGA: the real joined instrument routed on an ECP5, and the clock the board actually makes
    Two defects, both of which made a published number describe something other
    than the instrument.
    1. The FPGA build had no drums in it. fpga/Makefile's SRC list named nine files
    and none of them were drum_kit.v, drum_dp.v, drum_regs.v or modal_dp.v, so
    the 27 % logic / 43 % DSP / 33.01 MHz figures were a chip containing
    drum_section_placeholder. Rebuilt against main's joined synth_top:
    ECP5 LFE5U-25F routed, 13,792/24,288 TRELLIS_COMB (57 %),
    8,412 FF (35 %), 14/28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
2026-09-18 docs: the DAG carried red on four circuits that were fixed, and DL now has a measured cost (#38)
    The per-circuit table marked the bass drum, both toms and the cowbell red for
    defects that PR #14 and PR #32 closed: bd_attack_writes ships the 130 Hz/4 ms
    attack window, tom_pitch_drop_writes ships the diode bend, and the cowbell has
    per-oscillator sources with tau 98 ms. KNOWN_DEFECTS is empty and the
    acceptance suite passes 53 tests under TR808_STRICT=1, 15 of them covering
    exactly those fixes.
    This document has now carried stale findings twice -- the modal_dp exc hazard
    was the first -- so the correction is recorded in the table rather than quietly
    applied.
    Also records what the full librar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
2026-09-18 ci: run the integration checks, and freeze v0.3 at three notes and eight drums (#37)
    CI ran verify_ladder and verify_voice and stopped there -- block checks only.
    That is precisely the gap this project already fell into: every block was
    bit-exact against its model while the control link silently delivered 37 of 155
    register writes, because every bench drove the register write port rather than
    the link. Block-level green is not integration green, and the checks that would
    have caught it existed but were not wired up.
    Added to the per-push rtl job: verify_modal, verify_ctl and verify_synth_top,
    plus four controls that must turn them red -- SPI_ADDR7 and SPI_DATA24, which
    reinstate the rev-1 s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
2026-09-18 pnr: the joined synth_top routed -- evidence for the chip that actually has drums (#40)
    Rebased onto main by the coordinator rather than merged: PR #34 carried the
    first half of this branch and was squash-merged, which left the branch
    conflicting against its own already-landed content. The placeholder evidence is
    byte-identical on both sides; what is genuinely new is the joined-d1e5068
    evidence directory.
    The result it records: synth_top containing the real drum_kit/drum_regs engine
    routes on a fixed 3,464,960 um^2 die at 2,033,110 um^2 of cells, 60.1 %
    utilization, 0 router DRC, 0 antenna, TNS 0 at every corner with ss_125C_4v50
    at +10.173/+1.140 ns. Detailed routing drove 17,929 violation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
2026-09-18 docs: the target is a complete 808 and a complete mono Minimoog, validated against references (#41)
    Records the goal the intermediate builds are checkpoints toward, and the
    distinction that governs the work: testing the implementation and testing the
    sound model are different things, and this project has only done the first
    properly. RTL bit-exact against Python proves we built the model we specified;
    it says nothing about whether that model is the instrument we want. The drums
    have external ground truth -- 110 traced facts plus a real recording corpus.
    The voice has neither: its 42 acceptance tests check the implementation against
    our own decision records.
    Records what the automated suite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
2026-09-18 docs: root-cause the confident wrong answers — and what to automate (#43)
    * docs: root-cause the confident wrong answers, and say what to automate
    Eight measurement claims, three area projections and two 'confirmed defects'
    were withdrawn in one day. That is a mechanism, not carelessness.
    The root cause: internal consistency is cheap to check and external grounding
    is expensive, so work drifts toward the cheap check -- and the cheap check
    feels like rigour because it is rigorous in form. Validating estimators against
    our own model, testing the voice against our own decision records, verifying
    blocks without verifying integration, computing area instead of routing it, and
    arguing about a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
2026-09-18 ci: a nightly job for the checks a push cannot afford (#50)
    * ci: a nightly job for the checks a push cannot afford
    Per-push CI runs what is fast. The checks that would actually have caught this
    project's failures are the slow ones -- the full 255,060-frame voice run, the
    348,554-sample drum run, and every injected-defect control -- and they ran only
    when somebody remembered, which is the same as not running.
    Four jobs. full-rtl runs the bit-exactness suites at full length. controls runs
    eight injected defects including SPI_ADDR7 and SPI_DATA24, the exact frame that
    shipped broken, and requires the silent stub to fail the 808 suite; a nightly
    whose controls do not fire is a broken nightly,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
2026-09-18 docs: a gated ladder for using the software references (#59)
    Seven rungs, each answering a question and each able to fail, so a failure
    stops work below it instead of producing data nobody can act on.
    The ordering is the load-bearing part. Rung 1 -- do the references agree with
    each other? -- comes before rung 3 -- where do we sit? That single choice
    prevents most of the wasted effort: if Surge, Moog and Arturia differ by 20 %
    on a property, our 15 % difference from one of them is not a bug, and chasing
    it is a goose chase by construction. Nobody has measured inter-reference
    agreement yet.
    Rung 0 gates everything on the rig being trustworthy, because there are
    currently zero repeated rende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
2026-09-18 tools: compile the roadmap from evidence that is actually executed, gate it in CI (#57)
    * tools: compile the capability DAG from evidence, and render it into README
    The roadmap was maintained by hand and twice carried findings that had already
    been fixed -- the modal_dp exc hazard, and red on four repaired drum circuits.
    Both were claims that outlived their evidence (docs/failure-modes.md mechanism
    4). A hand-maintained status document cannot avoid that; a compiled one can.
    docs/dag.json declares each node WITH the evidence that would make it green --
    a git tag, a verifier, a suite, a committed report. tools/compile_dag.py checks
    that evidence and derives the status: STAMPED when an annota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
2026-09-18 docs: a second root cause — the apparatus, not the evidence (#63)
    * docs: a second root cause -- preconditions assumed rather than asserted
    The first analysis was about evidence: we validated against ourselves. A later
    cluster has a different cause, and naming it separately matters because the
    remedy is different.
    We verified what a tool measures, but not that it was in a state to measure
    anything. Diva contaminated every measurement it touched because it was an
    unlicensed demo. Model D renders exact silence because its authorisation is
    invisible to a host called Python. Surge renames parameters 259-267 by
    oscillator type, so a pinned index would have put a 13.75 Hz high cut on every
    mea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
2026-09-18 Evaluation: the filter under movement, which no test could see — and what Surge's source costs us (#58)
    * Evaluation: the filter under MOVEMENT, which no test could see -- and what Surge's source costs us
    Every filter measurement in this repository holds the cutoff still, so none of
    them can see zipper noise, which by definition only happens while a control
    moves. That is issue #46's "movement" criterion and it had no test at all.
    OUR CUTOFF CONTROL RESOLUTION, in closed form and needing no audio: the path
    is "cutoff in INTEGER Hz -> g in Q0.16 from a 128-entry ROM read with linear
    interpolation", so inverting the realised g gives the resolution in cents.
    30 Hz: 53.7 cents per step (1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
2026-09-18 tools: a tested job runner, one make target, and no bash for logic (#65)
    * build: one make target, because the prohibition did not work
    Two more waiting-turns happened within five minutes of committing a rule that
    said not to. A prohibition in a document does not change behaviour; removing
    the choice does.
    There is now no documented way to run 'some of the verifiers'. There is
    'make verify', and it runs them together in one turn through run_all.py.
    'make verify-full' adds the hour-long runs, 'make controls' runs every injected
    defect together.
    Also bans bash for anything with logic, with the reason rather than the
    preference: the bash run_all printed FAIL(??) for a job that exited 1, and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
2026-09-18 A complete Minimoog voice: the noise source, oscillator 3 as a modulator, the Model D waveform set -- and the cutoff tuning we had left out (#67)
    * Minimoog: the noise source, oscillator 3 as a modulator, the Model D waveform set -- and the cutoff tuning polynomial we had left out
    The acceptance suite has always checked the voice against OUR decision
    records. Nothing had ever checked that what we said is a Minimoog. This adds
    `docs/minimoog-reference.md` -- every claim tagged [verified] against the
    Model 204D service manual or a R. A. Moog drawing, [inferred] with the
    arithmetic shown, or [ours] -- and then builds to it.
    DR 0011, the cutoff tuning polynomial (landed first, because it moves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
    [ladder_dp.v, ladder_dp_n.v, tb_voice.v]
2026-09-18 docs: questions for a DSP expert, ranked by ROI (#76)
    Eight questions with our measurements attached so they can be answered
    concretely rather than in general.
    The first is the one we most want answered and the one we cannot explain:
    2x oversampling the oscillators made aliasing WORSE, -42.7 to -33.1 dB,
    reproducibly enough that we kept it as a test. Not understanding that means we
    cannot trust our own reasoning about the anti-aliasing question, which is our
    largest measured defect.
    Each question carries what we measured, what surprised us, and what we already
    tried and rejected -- including the quadratic tanh interpolator that was worse
    than linear, and the guard constant that turns out t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
2026-09-18 docs: preserve the v0.30 execution plan and scorecard as received (#83)
    Working documents from review, verbatim, so nothing is lost and later decisions
    can be traced to what they responded to. Inputs, not the repository's position.
    What v0.30 adds that our own drafts did not have:
    A continuous score -- worst normalized error = max(metric error / tolerance),
    passing at or below 1 -- so improvement is visible before a case passes. And
    the anti-gaming provision that matters: a missing component INVALIDATES the
    case rather than being omitted from the maximum, so dropping an inconvenient
    measurement cannot improve the number.
    Four separate reports never merged: coverage with its no-verdict rea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
    [instrument-scorecard-v0.30.xlsx]
2026-09-18 tools: the scorecard as executable evidence — and no XLSX in the repo (#84)
    * tools: the scorecard as executable evidence, and no XLSX in the repository
    The workbook is removed. A binary you cannot read from a console cannot be
    diffed, grepped or reviewed in a pull request, and this project is worked on
    from a console. The three sheets are exported as CSV and
    docs/scorecard/cases.csv is the machine-readable source the tooling reads --
    100 cases, 80 development and 20 holdout, Drums 32 / Mono 32 / Filters 24 /
    Ensemble 12.
    tools/scorecard.py renders the board and enforces five rules, each of which is a
    way a scorecard starts lying:
    An invalid measurement has NO distance rather than zero,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
    [cases.csv, history.csv, instrument-scorecard-v0.30.xlsx, progress.csv, release.csv, sound-cases.csv]
2026-09-18 Drums: the complete TR-808 — all sixteen sounds on eleven circuits (contract revision 9) (#74)
    * drums: all sixteen TR-808 sounds on eleven circuits (contract revision 9)
    Committed by the coordinator from the agent's worktree, which held 23
    uncommitted files after three hours. CLAUDE.md is explicit that interrupted
    agents' work survives there and has had to be harvested before; this is
    preservation, not a claim that it is finished.
    Per the agent's own report: three new circuits (MT/MC, CL/RS, CY) plus the four
    presets that were nearly free (LC, HC, MC, MA). MODES 12->16, NUMS 6->11,
    ENVS 12->18, PATHS 16->23, STOPS 8->11, PATH word 22->25 bits, mix bus
    21->22 bits.
    The 0xFF register col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
2026-09-18 [dag] regenerate the roadmap from evidence
    Automated. Status is derived by running each node's evidence, not asserted. See tools/compile_dag.py.
    [history.csv]
2026-09-18 references: Surge was making a pulse and calling it a saw (#87)
    The rig asked Surge for a saw and received a 50 % pulse; asked for a square and
    received the dual saw, which is not even at the commanded pitch. Both were
    published as references for a whole study. The request and the label agreed
    with each other and nothing compared either with the signal.
    Corrected by rendering, not by reading docs: saw is Shape 0.50 -- the CENTRE of
    a bipolar control, where Width has no effect at all -- square is 0.00/W50,
    pulse25 is 0.00/W25, and sine requires the Sine oscillator type because Classic
    has neither sine nor triangle.
    Three further apparatus faults, each of which had been silently shaping resu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
2026-09-18 spec: DR 0014 -- win the rubric before shrinking it (#86)
    Stop optimising for area until the instrument matches its references. Where
    matching needs more modes, banks, envelopes or paths, add them.
    The measurement that settles it: on the real half-slot template the joined chip
    is 2,033,110 um^2 against a 5,020,056 um^2 core -- 40 %, or 30 % with *_1 cells
    allowed. Headroom is 2,986,946 um^2, which is 147 % more than the entire chip.
    We could double the modal bank and land at 51 %. The complete sixteen-sound 808
    cost 1.3 % of the chip.
    There is no area problem. There was an area premise, inherited from a quarter
    slot that was the wrong target, and it survived long after the measurement that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
2026-09-18 rename: gf180-monosynth -> gf180-parasynth (#89)
    The repository was named for a voice it outgrew. The product goal is
    paraphonic -- four-note chords from three detuned oscillators into one
    ladder -- so "monosynth" described neither what ships nor what is being
    built. gf180-polysynth is archived; that line is retired.
    Updated: README title, NUMERIC-CONTRACT's product line, and the GitHub
    URLs in the execution plan and release board. NOT updated: fpga/Makefile's
    hardcoded interpreter path, which is a local filesystem path rather than
    the repository name -- the working directory keeps its old name because
    fourteen live worktrees reference it by absolute path.
    GitHub redirects the old URL, so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
    [release.csv]
2026-09-18 refaudio: an index of real-hardware recordings, and a fetch tool that can refuse (#88)
    Adds refaudio/ -- a catalog of 89 packs of recorded synthesizers, samplers and
    drum machines (172,182 WAVs, ~121 h) now available to this project for training
    and verifying the design -- and tools/refaudio_fetch.py to pull a named
    recording from operator-side storage.
    The index is committed; the audio is not. 63 GiB of WAVs has no place in a git
    history, and most hosts cannot reach the storage anyway. What someone working
    here needs is to know what exists and what to call it, so they can fetch it on
    a host with a route or ask for it -- better, for a measurement of it -- through
    a `reference-audio` issue.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
    [808-from-mars.tsv, 808_from_mars_legacy.tsv, micro_from_mars.tsv, mini_from_mars.tsv]
2026-09-18 integration: the six joins the chip-level bench could not see (#90)
    Every block was bit-exact and the join was untested. These are the six cases
    from #82, built against main's already-integrated kit rather than re-landing it.
    Case 5 first, because it is the one that fails silently: a mix that uses the
    previous frame's drum bus produces entirely plausible audio. One frame at
    48 kHz is 21 us -- inaudible as a defect, invisible in a spectrum, and wrong.
    Three new controls, each watched failing before the rest was written:
    DRUM_BUS_STALE buses registered at `go` -- handshake satisfied, format
    right, deadline met, audio one frame old
    DRUM_DONE_NOWAIT the handshake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
    [drum_regs.v, synth_top.v, verify_ctl.py, verify_synth_top.py]
2026-09-18 Voice: explain the 2x oversampling aliasing regression (#80) (#91)
    Oversampling worked; the rate reduction is what cost 22.4 dB. At 96 kHz the
    corrected sawtooth reads -55.5 dB, the estimator's floor and 12.8 dB better
    than the -42.7 dB we ship at 48 kHz. Keeping the last sub-step then folds the
    24-48 kHz band into the baseband, and the share of power held there EQUALS the
    decimated reading at every register within 0.3 dB. Those harmonics do not exist
    at 48 kHz: oversampling created them and the drop-decimator aliased them.
    All four hypotheses tested rather than argued. PolyBLEP was not rate-mismatched
    (peak ratio 1.0000, one sample per side at both rates). Fixed point is not
    involved (floa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
2026-09-18 The scorecard, populated: 16 of 100 cases have a verdict (#93)
    * scorecard: case runner with provenance on every record
    tools/run_case.py renders a case and writes results/<case_id>.json carrying
    the commit, branch, dirty flag, engine and input hashes. No verifier here
    recorded what it ran against, so a result could not be told apart from a
    stale one -- with fourteen worktrees live that is not hypothetical.
    The board reads 3 of 100 valid, 2 of 3 inside tolerance, 13 no-verdict,
    84 not run. Missing verification is reported as missing rather than as a
    zero: a case that did not run and a case that ran and failed need opposite
    responses.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
2026-09-18 docs: the cymbal's shoulder is a mistuned filter, not a missing one (#97)
    The docstring on test_cymbal_band_split_against_the_machine_and_what_is_still_missing
    said the 9-13 kHz shoulder "wants a resonant filter near 10.5 kHz" and, in the
    next clause, that the model "drops Hh1". Read together those name one filter.
    They are two: Hh1 is a LOW-band filter at 2.5 kHz Q 0.97, and the 10.5 kHz one
    is M_CYHI, which the model already has.
    I briefed an agent from this paragraph to go and restore a filter near 10.5 kHz.
    It derived Hh1 from the component values, restored it, and closed 0.4 of the
    shoulder's 8.0 points while moving 5-9 kHz the wrong way -- refuting the premise
    at the first step, which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
2026-09-18 scorecard: refuse to report silently from a stale tree (#98)
    The board read "0 of 100" for hours after it actually read 16. Nothing was
    lost and nothing was broken: the working checkout sat on a branch that had
    already merged, ten commits behind main, and the board described that tree
    with complete confidence. The reader had no way to tell.
    That is the same failure as an estimator answering when its preconditions do
    not hold -- the output is indistinguishable from a current one. CLAUDE.md
    already requires preconditions to be asserted at the point of use; this
    applies it to the tool people actually read for status.
    The banner goes in the report, and to stderr as well when stdout is
    redirect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
2026-09-18 Analysis conventions: what the field does, what we do, and six changes (#120)
    * docs: analysis conventions, sections 0-3 (padding, onset alignment, band energy)
    Sourced from the scipy filtfilt/sosfiltfilt documentation, with the
    padding artefact re-measured: the default padlen for our 4th-order
    BAND-PASS is 27 samples / 0.562 ms at 48 kHz, not the 12-15 samples
    that #101 and #103 quote (that is the low/high-pass figure).
    * docs: analysis conventions, sections 4-8 (decay, aliasing, VA literature, verdict table)
    Two defects found by measurement while writing this:
    - schroeder_t20's tail_db truncation guard is nearly vacuous on a clean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
2026-09-18 Rescue: the hi-hat probes an agent left in a scratchpad (#105)
    * rescue: the hi-hat probes an agent left in a scratchpad
    An agent spent a long investigation on the 808 hat and cymbal high band,
    produced a result that refuted its own hypothesis at the first step, and
    committed nothing. Its branch has zero commits. The findings survived only
    because they were transcribed by hand into a docstring (#97); the apparatus
    that produced them was sitting in a session scratchpad.
    725 lines, recovered verbatim. One change: they were written against a
    worktree at /tmp/wt-hihat that no longer exists, so that path now resolves
    from __file__. Verified: all six compile and hh_probe.py runs, printing its
    ow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
2026-09-18 The tom pitch drop is not x1.7 — measured x1.06 / x1.14 / x1.24 from 99 files (#110)
    * measure: the toms' diode pitch drop, from recordings of a real 808
    The instrument and its validation, committed mid-measurement.
    `model/tom_pitch_probe.py` tracks f0 per period from interpolated
    same-direction zero crossings behind a Schmitt trigger. No filtering on the
    default path: `model/test_tom_pitch_probe.py` shows band-limiting costs 40 %
    of the excess (filtfilt pre-ringing lands on the first retained period) and
    biases the null low, so it is off and stays off.
    The gate, on synthetic toms with a KNOWN drop -- real 2-pole resonators kicked
    by a 1 ms pulse, with a dither floor, 24-bit quantisatio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
2026-09-18 scorecard: count onsets only inside the span events were written in (#112)
    A decaying 49 Hz kick's analytic envelope beats hard enough to look like a
    strike 754 ms after the last scheduled hit, so the ensemble cases were
    counting phantom onsets and failing on them. Counting only inside the span
    the events were actually written in turns E1A and E2A into passes at worst
    0.20.
    E1B deliberately stays a no-verdict. Onset detection cannot resolve a tom
    re-struck 121 ms into its own ring at the estimator's 12 dB rise threshold,
    and lowering that threshold to make the case pass would be fitting the
    instrument to the answer. A stated no-verdict is the honest outcome.
    Recovered from an uncommitted w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
2026-09-18 A frozen reference profile: Filters unblocked, and the Model D cross-check does not exist (#121)
    * references: split the stepped-tone render from its projection
    A frozen reference profile has to cache the AUDIO and re-derive the curve
    from it. Freezing a curve instead freezes a number nobody can re-measure.
    `tone_gain_db` is the same measurement it was: it now calls `tone_render`
    and `tone_project`, which are the two halves of its old body.
    * refprofile: the tool that freezes a reference, and refuses
    Renders each reference clip once through the qualified rig of #87, caches
    the audio, hashes it, and writes a committed profile.json desc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
2026-09-18 The machine's own spread, measured — and two board metrics that measure the apparatus instead (#126)
    * measure: corpus loader and the board's own BD estimators, for #111
    The take-to-take question needs the estimators the board actually scores
    through, not a second copy of them, so they are imported from run_case.py.
    Two are added here: the #101 windowing control (the same split with 10 ms of
    silence in front of the strike, since every file in this corpus opens ON the
    strike) and a #118 length criterion for T20, measured by cutting 10 % more off
    and re-reading -- audio_measure.py is owned by another agent, so neither
    touches it.
    24-bit files, so soundfile and not wavfile+/32768, asserted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
2026-09-18 refprofile: the Model D verdict is host-scoped, not a plugin property (#128)
    The README recorded "renders exact silence headlessly... it simply makes no
    sound". True of the configuration it was measured in -- the agent scoped its own
    claim correctly -- but the file presents as authoritative and a reader next year
    takes it as a property of Model D.
    Model D renders at full level under pedalboard: peak 1.000, 8.57 % of samples at
    the rail, strongest partial 131.00 Hz for MIDI 60 -- an octave down, the same
    default as Mini V3, which is itself the exact reverse. It is a property of the
    host. #123 caught in the wild, and the first instance already written into a
    file that looks like a reference.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
2026-09-18 fpga: the verified engine is playable through the production control path (#81)
    The keyboard demo drove the floating-point audition engine from early in the
    project, so every sound demonstrated so far was produced by poking internal
    model state. This closes that gap.
    THE CHEAP GATE FIRST, measured before the host was written. A transaction plus
    its CS_N gap is 24.326 us at the DR 0007 ceiling; a frame is 20.833 us. So a
    transaction is LONGER than a frame and at most one register write lands per
    frame -- no burst ever arrives together, at any legal clock.
    The thing #81 said to stop on survives by two orders of magnitude: the BD attack
    window is 192 frames wide and needs 2.34, leaving 3.95 m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
2026-09-18 refprofile: refuse non-finite audio, which a matching hash does not exclude (#133)
    load_clip ran seven checks -- profile membership, file exists, byte count,
    sha256, sample rate, frame count, and not-silent -- and ALL-NAN AUDIO PASSED
    EVERY ONE. So did all-Inf, and so did a clip with one NaN in the middle.
    The mechanism is that a non-finite sample defeats the one content check there
    was: NaN and Inf both compare False against the silence threshold, so
    `np.abs(y).max() <= 1e-9` is False and the clip is judged "not silent".
    A matching sha256 says the bytes are the ones the profile describes. It says
    nothing about whether those bytes are numbers. The integrity check and the
    validity check are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
2026-09-18 The repaired measurement path, and every drum case re-run against it (#132)
    * audio_measure: the truncation guard is a length, the aliasing floor is measured (#118, #119)
    schroeder_t20 refused on tail_db -- the backward-integrated curve's last
    value -- and that test is nearly vacuous on a clean record, because the
    backward integral of ANY finite record falls towards -inf at its last sample
    whatever was cut off it. Measured: a 100 ms cut of a 92.10 ms T20 reads
    -18.4 % while tail_db reports -79 dB against a -35 dB requirement.
    The estimator itself is correct and is not touched -- python-acoustics and
    pyroomacoustics independently confirm the backward cumulative sum, the -5 dB
    start, the -5.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
2026-09-18 Audio distance metrics: reject as a target, adopt one as a guard, and the guard is blocked on alignment (#144)
    * probe: does a multi-scale spectral distance resolve our errors above its own floor?
    Four published multi-scale spectral distances implemented from their
    definitions, each gated on a closed-form answer before it is used: identical
    inputs must read exactly 0 and a pure x2 gain exactly 1.0 / ln 2. That gate
    earned its place twice in one session -- it caught a mel filterbank whose
    empty low bands diluted every reading by 10 %, and the unit error that turned
    the decay sweep into 1e128 was caught by reading the sweep, not the gate,
    which is recorded in the docstring because it is the f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
2026-09-19 CLAUDE.md: say what this block is a canary FOR, and that filing upstream counts (#147)
    The README called this "a 2AM Logic canary block" and "a deliberately awkward
    canary" without ever saying what it is a canary for. So agents treated tool
    defects as obstacles to work around rather than as the output.
    Two concrete klt findings sat in pnr/klt/ladder_dp/run-klt.sh as comments for
    weeks -- klt emitting netlists its own place-and-route cannot consume, and klt
    silently placing no tapcells, no PDN and no fillers when given no power block.
    The discovery work was done; only the filing was missing. They are now
    klayout-tools#2085 and #2086.
    The rule added: if you work around a tool rather than a b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
2026-09-19 Two more cutoffs frozen: Filters goes 1 valid to 3, and the corner mapping droops faster than Surge's (#146)
    * refprofile: freeze the 1 kHz and 4 kHz cutoff regions, and a tool that checks the freeze is one
    `docs/scorecard/cases.csv` names three cutoff regions for the filter family --
    250 Hz, 1000 Hz, 4000 Hz, each "verified by measurement". The profile froze
    one, which is what run_case.py's twenty `out of scope for this reference
    profile` entries were about. This adds the res-0 stepped-tone clip at each of
    the other two: exactly what F1B and F1C read, and nothing else, because the
    remaining eighteen cases are blocked on things other than the cutoff.
    The new clips are APPENDED rather than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
2026-09-19 The discrimination study, re-run for all sixteen sounds — and four things it withdrew from its own harness (#148)
    * discrimination: the documented re-run, against today's model
    The study's own scorecard says "re-run this study before quoting it". This is
    that re-run, unmodified harness, same corpus, same documented invocation.
    .venv/bin/python model/discrimination_run.py --refs /tmp/tr808-ref \
    --out <out> --json docs/discrimination-results.json
    .venv/bin/python -m pytest model/test_discrimination.py -q # 12 passed
    tree measure-discrimination-current @ c752145 (clean), model sha e05bf2d972b6c9ce
    corpus tidalcycles/sounds-tr808-fischer 85fbecf, 116 WAVs, sha256 e3ad2d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
2026-09-19 voice_fx: say that we DO apply Huovilainen's polynomial, because we do (#149)
    The comment read "...and Surge XT's LP Vintage Ladder Type 2 applies it
    (sst-filters VintageLadders.h ...). We did not, and the self-oscillation
    frequency drifted 9.84 percentage points ...".
    That described the state BEFORE DR 0011. Read in the present tense it says
    Surge applies the polynomial and we do not -- and an agent measuring a corner
    discrepancy across three cutoffs read it exactly that way and reported the
    discrepancy as explained by our not applying it.
    We do apply it. fcr() is the polynomial; model/fixed.py's cut_to_coeff is
    `c * CUT_TRIM * fcr(c)`, so the shipped coefficient ROM carries it.
    A commen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
2026-09-19 docs: a handoff that survives a lost session (#151)
    Captures the board and what its number means, the DAG's two outstanding items,
    every in-flight branch and whether it is pushed, the three highest-value open
    findings, the constraints that will bite, and the repeating guard-defeat pattern
    with its four instances.
2026-09-19 docs: delete HANDOFF.md -- it was a fifth copy of state four artifacts already hold (#153)
    Added an hour ago and wrong on its own terms. It duplicated:
    the board table -> tools/scorecard.py computes this from evidence
    "in flight" branches -> git knows this, and the note is stale in an hour
    next steps -> that is what issues are for
    domain constraints -> each already lives in the doc that owns it
    Verified before deleting: the conga/tom shared-circuit constraint, the
    single-machine corpus limit (Fischer s/n 103852) and the host-per-plugin
    finding are all already recorded in docs/, spec/, refaudio/ and refprofile/.
    A prose copy of a computed artifact is stale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
2026-09-19 The toms' pitch drop, corrected against measured hardware — and the defect it was masking (#154)
    * tom_drop_fit: derive the pitch-drop law from the 99-file measurement, with four hold-outs
    No coefficient changes here. This turns PR #110's per-file table into the
    constants drums_fx needs, and then tries to break them on settings it did not
    use.
    excess(accent, f0) = max(0, K * (accent - A0[position])) * exp(G * u)
    u = f0 / f0_centre(position) - 1
    K = 0.182, A0(tom) = 0.670, A0(conga) = 1.064,
    G(tom) = 3.58 +- 0.14, G(conga) = 7.46 +- 0.09
    Held out, the law never having seen the test rows:
    accent level B unseen (fit A + C) n=33 bias -0.018 rms 0.029
    even tuning positi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
2026-09-19 refprofile_repro: reproducibility and continuity are two verdicts, not one (#156)
    exit 0 meant "every run agreed, clip for clip, byte for byte" -- i.e. the rig
    agrees with ITSELF. It said nothing about whether that agreed-upon thing is
    what the committed profile describes, so a host that reproducibly rendered
    something DIFFERENT from the frozen reference exited 0.
    The tool already computed and printed the comparison (`against_committed`);
    the drift simply never reached the exit code, so a caller had to know to look.
    Found by external audit.
    Drift is a mismatch, so it is exit 1 under this repo's 0/1/2 convention.
    `--allow-drift` is the deliberate override for a reference that is MEANT to
    mo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
2026-09-19 DR 0015 — the scorecard is the acoustic acceptance authority (#157)
    * spec: DR 0015 -- the scorecard is the judge
    Answers #99, which has blocked every coefficient change since it was filed.
    The scorecard judges, per-property and per-case. Spectral distances are
    rejected as targets because they rank our real tom defect BACKWARDS -- all
    four, with two putting the largest possible error closer than a small one.
    Knob-equivalents are rejected across voices because 12 of 16 saturate on a
    shared ruler. No learned or aggregate score, because a design loop needs a
    metric that says what to fix.
    Corrects DR-adjacent guidance in #100: fit and score with the SAME metric.
    Independence comes from held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
2026-09-19 The excitation excess is a missing DC block, it is two mechanisms not one, and #152's sixteen voices are six (#160)
    * The instrument for #152's excess, with its own floors measured
    `tools/probes/excitation_energy.py`. Eleven self-tests, all green, including
    two injected-bug controls (a DC pedestal the map must find, and a signal with
    no energy under 400 Hz that the STUDY's conditioning reports as low-frequency
    anyway).
    Three floors, each measured rather than assumed:
    F1 `test_discrimination.condition()` high-passes with `sosfiltfilt`. Fed a
    unit impulse at index 0 it answers with a near-full-scale NEGATIVE
    pedestal -- second sample -0.997 -- whose first 30 ms integrate to -373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
2026-09-19 condition()'s boundary was flattering us: BD 2.5 to 4.0, HT 4.6 to 5.9, CY 8.1 to 8.6 (#166)
    * Start red: the impulse control and the #103 lead-invariance test that condition() fails
    Three controls, all failing at HEAD, plus the two helpers #163 rule 1 asks for.
    test_conditioning_does_not_answer_an_impulse_with_a_pedestal
    unit impulse at index 0, second sample -0.994 (want |y[1]| < 0.05),
    first 30 ms integrating to -342 at 44.1 k and -373 at 48 k against a
    causal filter's +0.02.
    test_a_measurement_does_not_depend_on_where_the_record_begins
    10 ms of silence ahead of the onset moves the 320 feature columns by
    up to 0.069 in log10 power (0.69 dB). A converte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
2026-09-19 The filter droop was the instrument: 8.2 of 8.23 points, leaving a constant -16.6% corner error (#170)
    * refprofile: the cache re-rendered and reproduced, which is what unblocks the reference side
    #164's repair could only rescore our side of F1A/F1B/F1C: `refprofile/cache/`
    is gitignored and was absent on that host, so `refprofile.load_clip` refused
    every frozen Surge clip and `run_case.py` wrote no-verdicts for the reference
    half of the comparison.
    Re-rendered here on the qualified rig (Surge XT 1.2.3, dawdreamer 0.9.0,
    macOS/arm64, Python 3.14.7) and checked the way #156 says to check it -- which
    distinguishes "the runs agree with each other" from "the runs agree with the
    committed profi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
2026-09-19 Recover the upstream tool findings ledger (#171)
    * docs: a ledger of tool defects found here — three filed, and what was judged not filable
    A comb of pnr/, docs/, fpga/, git log and this repo's issues for tool defects
    that had been recorded only as workarounds in shell scripts, run logs and doc
    footnotes.
    Filed in 2AMLogic/klayout-tools:
    - #2088 klt synthesize has no gf180mcu_fd_sc_mcu7t5v0 entry in ANY per-library
    table -- the #1649 counterpart on the synthesis side. One missing dict key
    costs -constr, setundef -zero and hilomap at once, and the response says
    status ok / warnings 0 / timing null for a request that supplied a clock
    period. It also makes #2006's x-constant fix in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
2026-09-19 Recover the conga spectrum study with enforced measurement controls (#174)
    * measure: the congas' 1.04 is a window, not a defect
    D04A and D08A fail at 1.04 and 1.05 on `body spectrum`. Neither number is a
    property of the model or of the machine: the two sides of the comparison are
    not windowed alike, and the apparatus term that creates is up to 6.07 dB
    against a 3.0 dB tolerance.
    `prepare` trims to 1 ms before the onset when there is 1 ms of signal there to
    keep. The Fischer references begin AT the strike (first sample above 2 % of
    peak is sample 7), so their window opens 0.16 ms early; our render leads with
    10 ms of digital silence, so its window opens at exactly 1.00 ms. band_energy
    filt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
2026-09-19 Make acoustic comparisons respect the real measurement basis (#172)
    * Reproduce inert acceptance basis on committed result records
    Start red on shipped scorecard: estimator/reference changes and missing apparatus must refuse comparison. Recover real-record tests from the interrupted #168 work.
    * Preserve and compare the actual measurement basis (#168)
    Recover the interrupted fix and include reference content hashes, settings, and metric definitions. Require apparatus identity; device hashes, timestamps, and cache paths are not the measurement basis. Real-record controls: 29 failed before, 43 passed after.
2026-09-19 fix filter rolloff basis and distinguish injected controls (#178)
2026-09-19 Measure qualified mono high-note oscillator case (#179)
